CTSchorsch/gesc/pdf/3dview.png

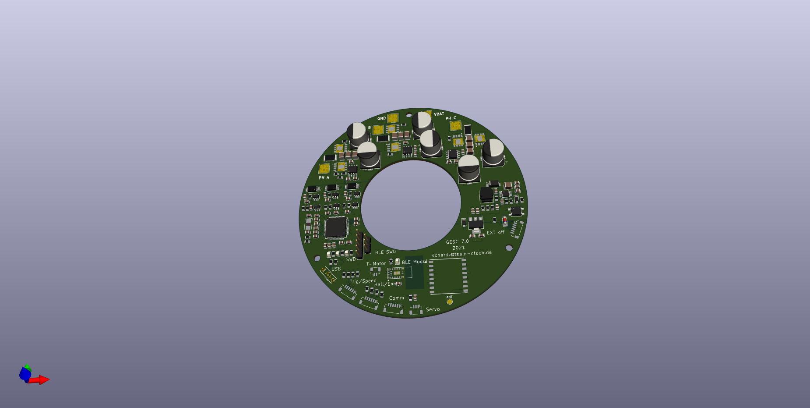
pdf/3dview.png
