CTSchorsch/gesc/README.md

# gesc
DC Motor Controler based on Benjamin Vedders VESC(TM)

Round shape, fits into a DPV tube.
48V (13s), max 60A, needs cooling
