CTSchorsch/gesc/assembly/gesc_lcsc.xlsx

Comment | Designator | Footprint | LCSC
10n0 | C14,C24,C41 | 0805 | C1710 (https://lcsc.com/product-detail/Multilayer-Ceramic-Capacitors-MLCC-SMD-SMT_SAMSUNG_CL21B103KBANNNC_10nF-103-10-50V_C1710.html/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)
10u0/75V | C16,C36,C37,C38,C39,C43,C44,C51,C52,C53
100n | C1,C2,C5,C17,C18,C19,C20,C21,C25,C27,C30,C31,C32,C33,C45,C46,C48 | 0805 | C49678 (https://lcsc.com/product-detail/Multilayer-Ceramic-Capacitors-MLCC-SMD-SMT_100nF-104-10-50V_C49678.html/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)
1n00 | C23,C35,C40,C47 | 0805 | C46653
22u0/25V | C26,C28,C34,C50 | 0805 | C45783 (https://lcsc.com/product-detail/Multilayer-Ceramic-Capacitors-MLCC-SMD-SMT_SAMSUNG_CL21A226MAQNNNE_22uF-226-20-25V_C45783.html/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)
15p0 | C3,C4 | 0805 | C1794
10u0/25V | C6,C7,C8,C9,C10,C11,C12,C13,C15,C22,C29,C42,C49 | 0805 | C15850 (https://lcsc.com/product-detail/Multilayer-Ceramic-Capacitors-MLCC-SMD-SMT_SAMSUNG_CL21A106KAYNNNE_10uF-106-10-25V_C15850.html/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)
330u | C54,C56
BLUE | D1 | LED_0805 | C2293 (https://lcsc.com/product-detail/Light-Emitting-Diodes-LED_Hubei-KENTO-Elec-Blue-light_C2293.html/?href=jlc-SMT)
RED | D2,D11 | LED_0805 | C2296 (https://lcsc.com/product-detail/Light-Emitting-Diodes-LED_Yellow-light-0805-Highlighted_C2296.html/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)
GREEN | D3 | LED_0805 | C2297 (https://lcsc.com/product-detail/Light-Emitting-Diodes-LED_Green-0805-Iv-207-249-mcd-atIF-20mA_C2297.html/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)
SS210 | D4,D8 | SMA,DO-214AC | C14996
B5819W | D5,D6,D7 | SOD-123 | C8598 (https://lcsc.com/product-detail/Schottky-Barrier-Diodes-SBD_Changjiang-Electronics-Tech-CJ-B5819W_C8598.html/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)
330u | L1 | SMD-12.5x12.5x8 | C169381 (https://lcsc.com/product-detail/Power-Inductors_Sunlord-SWRB1207S-331MT_C169381.html/?href=jlc-SMT)
4u70 | L2 | SMD-5.2x5.4x2.8 | C408410 (https://lcsc.com/product-detail/Power-Inductors_Sunlord-MWSA0503S-4R7MT_C408410.html/?href=jlc-SMT)
BSC070N10NS5 | Q1,Q2,Q3,Q4,Q5,Q6 | PG-TDSON-8_EP_5.2x6.2x1.27P | C151549 (https://lcsc.com/product-detail/MOSFET_Infineon-Technologies_BSC070N10NS5ATMA1_Infineon-Technologies-BSC070N10NS5ATMA1_C151549.html/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)
221r | R10,R11 | 0805 | C17557 (https://lcsc.com/product-detail/Chip-Resistor-Surface-Mount_Uniroyal-Elec-0805W8F2200T5E_C17557.html/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)
220k | R12 | 0805 | C17556 (https://lcsc.com/product-detail/Chip-Resistor-Surface-Mount_Uniroyal-Elec-0805W8F2203T5E_C17556.html/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)
100k | R15 | 0805 | C17407 (https://lcsc.com/product-detail/Chip-Resistor-Surface-Mount_Uniroyal-Elec-0805W8F1003T5E_C17407.html/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)
10r0 | R2,R3,R5,R25,R26,R28,R32,R42,R43 | 0805 | C17415 (https://lcsc.com/product-detail/Chip-Resistor-Surface-Mount_Uniroyal-Elec-0805W8F100JT5E_C17415.html/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)
56k0 | R13,R17,R19,R21 | 0805 | C17756 (https://lcsc.com/product-detail/Chip-Resistor-Surface-Mount_Uniroyal-Elec-0805W8F5602T5E_C17756.html/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)
0r001 | R31,R45,R46
7k50 | R35 | 0805 | C17807 (https://lcsc.com/product-detail/Chip-Resistor-Surface-Mount_Uniroyal-Elec-0805W8F7501T5E_C17807.html/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)
0r00 | R1,R37 | 0805 | C17477 (https://lcsc.com/product-detail/Chip-Resistor-Surface-Mount_Uniroyal-Elec-0805W8F0000T5E_C17477.html/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)
4r75 | R24,R38,R39 | 0805 | C17675 (https://lcsc.com/product-detail/Chip-Resistor-Surface-Mount_Uniroyal-Elec-0805W8F470KT5E_C17675.html/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)
33k0 | R44 | 0805 | C17633 (https://lcsc.com/product-detail/Chip-Resistor-Surface-Mount_Uniroyal-Elec-0805W8F3302T5E_C17633.html/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)
2k70 | R4,R6,R7,R14,R18,R20,R22,R23 | 0805 | C17530 (https://lcsc.com/product-detail/Chip-Resistor-Surface-Mount_Uniroyal-Elec-0805W8F2701T5E_C17530.html/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)
11k0 | R8,R16,R27,R34,R36,R40,R41 | 0805 | C17429 (https://lcsc.com/product-detail/Chip-Resistor-Surface-Mount_Uniroyal-Elec-0805W8F1102T5E_C17429.html/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)
1k00 | R9,R29,R30,R33 | 0805 | C17513 (https://lcsc.com/product-detail/Chip-Resistor-Surface-Mount_Uniroyal-Elec-0805W8F1001T5E_C17513.html/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)
STM32F405RGTx | U1 | LQFP-64_10.0x10.0x0.5P | C15742
LM5008MM | U10 | VSSOP-8_3.0x3.0x0.65P | C9424
SN74LVC1G66DBVR | U2,U7,U8,U9,U11,U13 | SOT-23-5 | C133643
AQY282S | U14 | SOP-4_4.3X4.4X2.54P | C250827
EYSGJNZWY | U16
LMR12010YMKE_NOPB | U17 | SOT-23-6L | C57930
LM5107 | U3,U12,U15 | SOIC-8_3.9x4.9x1.27P | C132096
INA240A1 | U4,U5,U6 | TSSOP-8_3.0x4.4x0.65P | C93965
X50328MSB2GI | Y1 | SMD-5032_2P | C115962
