CTSchorsch/gesc/pdf/gesc.pdf

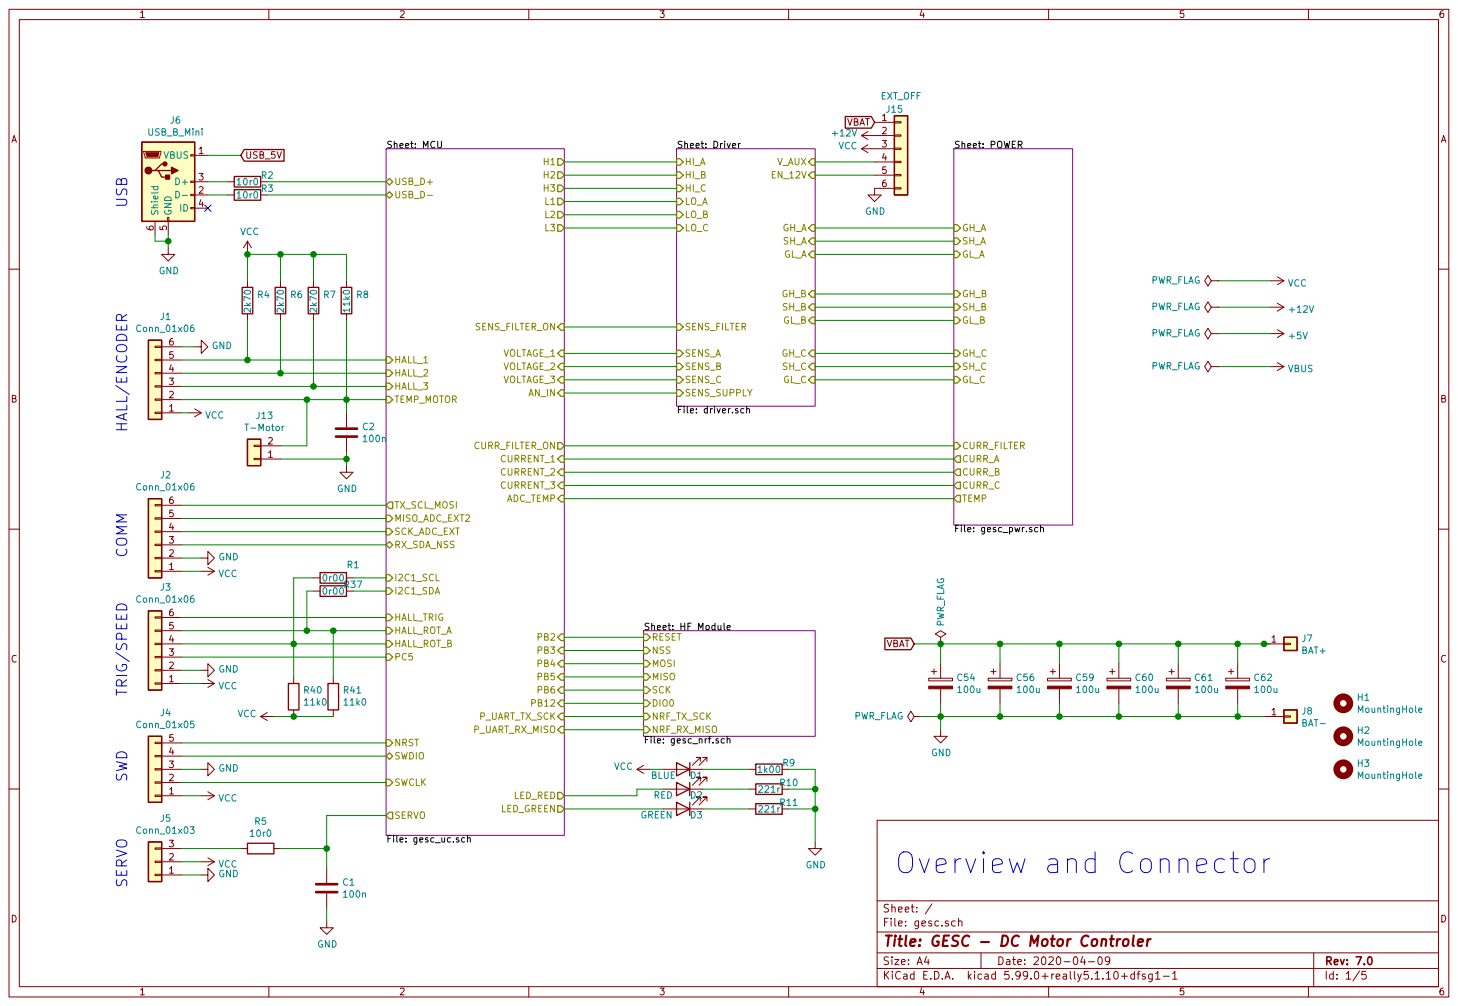
[picture p2: page 1]

File: gesc.sch Sheet: / Sheet: HF Module File: gesc_nrf.sch NRF_TX_SCK NRF_RX_MISO MOSI NSS RESET SCK MISO

Id: 1/5 Title: GESC - DC Motor Controler

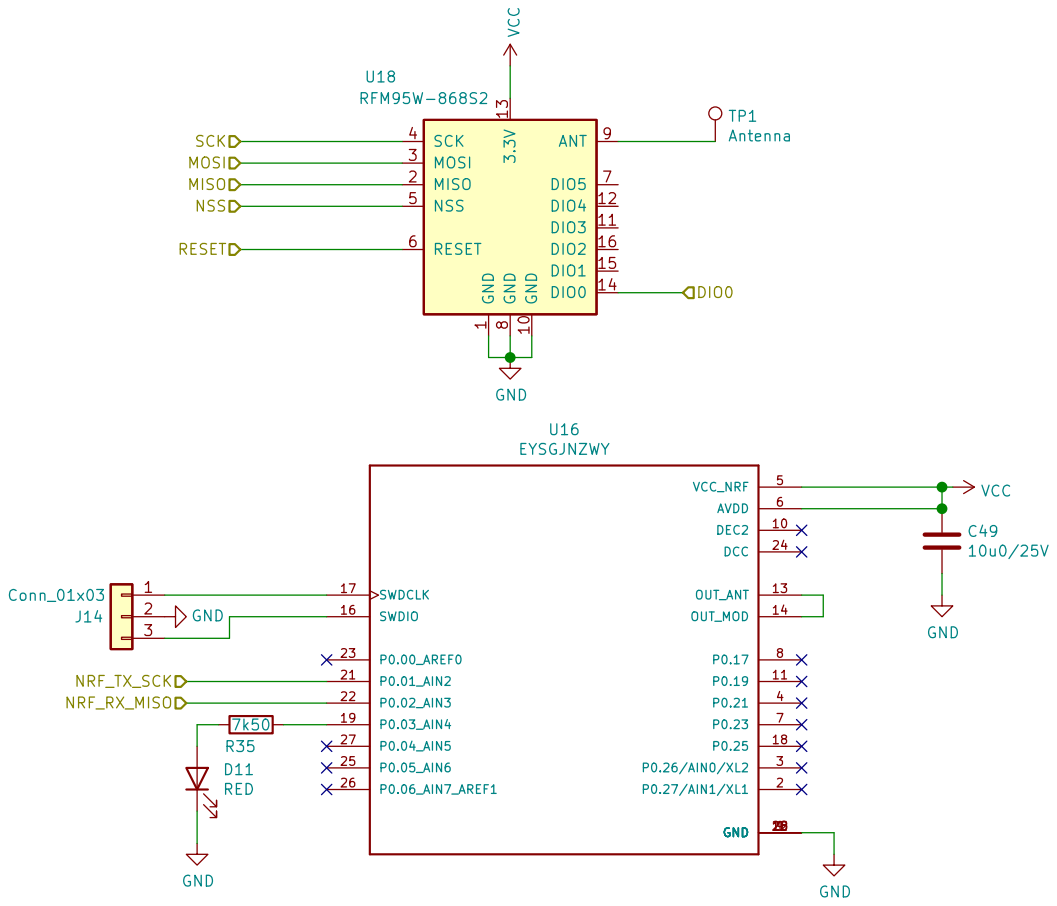
[picture p3: page 2]

8 ANT 9 U18 RFM95W-868S2 C49
File: gesc_nrf.sch Sheet: /HF Module/ GND GND

1 GND 10 DIO3 11 DIO4 12 3.3V 13 DIO0 14 DIO1 15 DIO2 16 MISO 2 MOSI 3 SCK 4 NSS 5 RESET 6 DIO5 7 GND

Id: 2/5 Title: GESC - DC Motor Controler

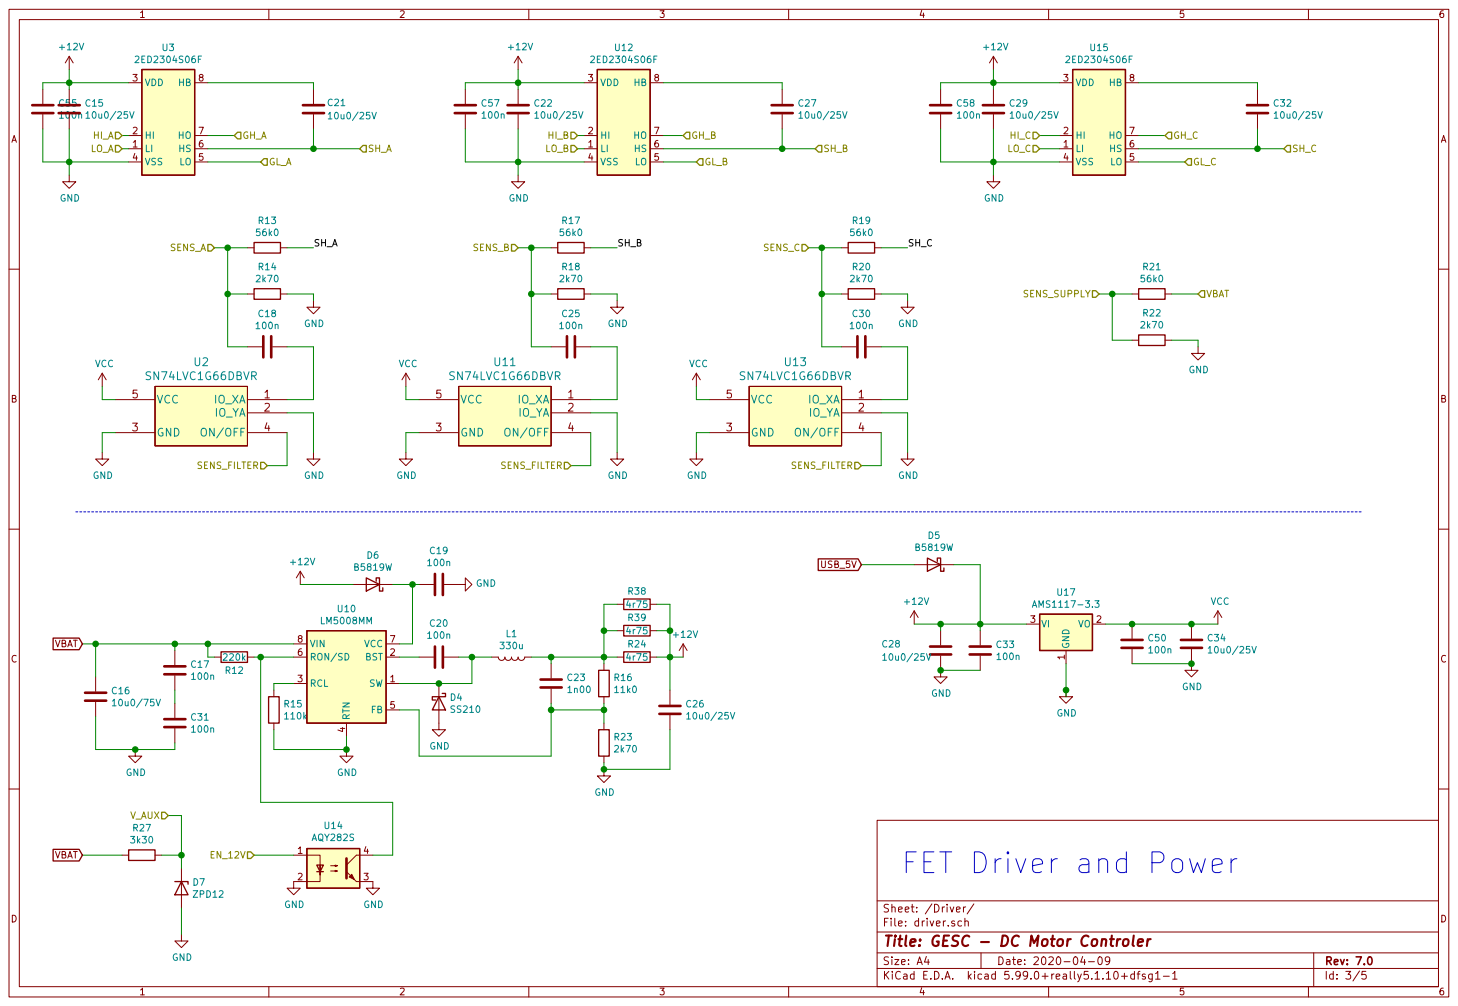
[picture p4: page 3]

4 FB 5 RON/SD 6 VCC 7 VIN 8 U10

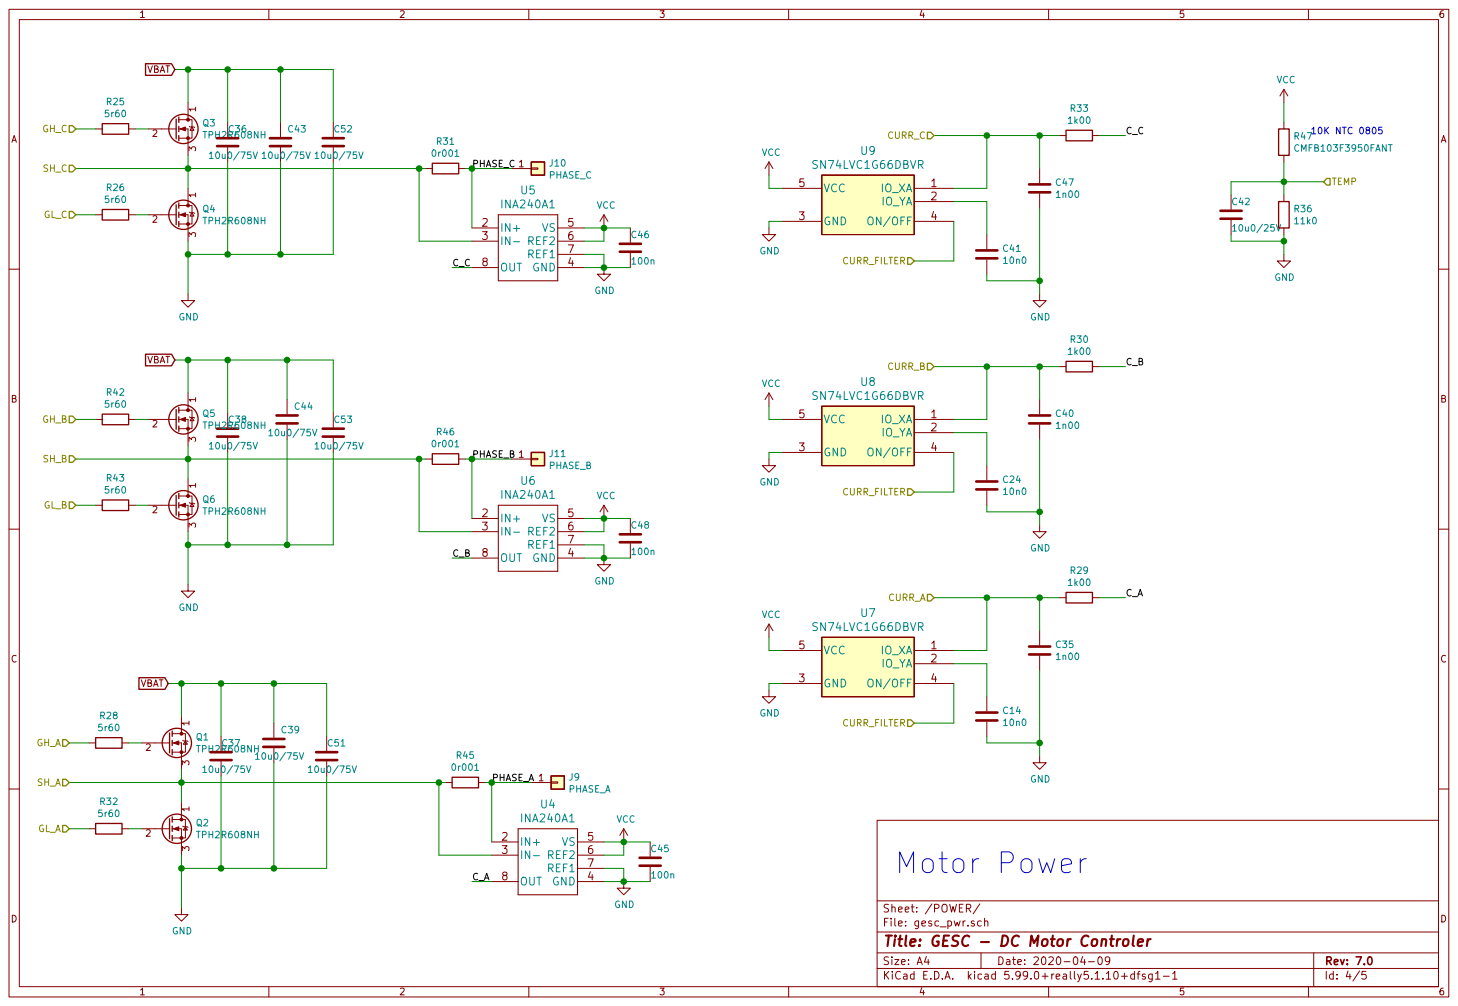
[picture p5: page 4]

File: gesc_pwr.sch Sheet: /POWER/
Id: 4/5 Title: GESC - DC Motor Controler

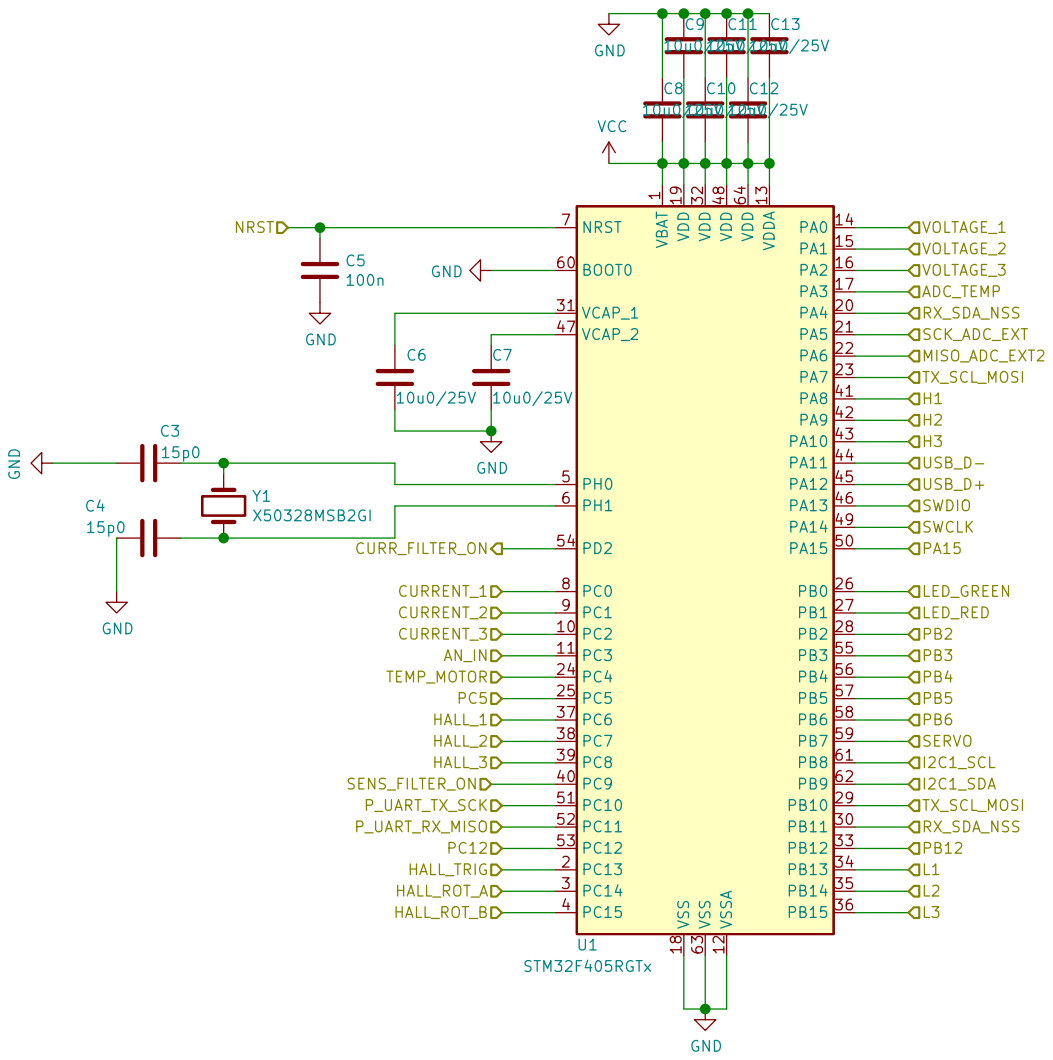
[picture p6: page 5]

File: gesc_uc.sch Sheet: /MCU/ GND

Id: 5/5 Title: GESC - DC Motor Controler
