CTSchorsch/gesc/gerber/gesc-F_CrtYd.pdf

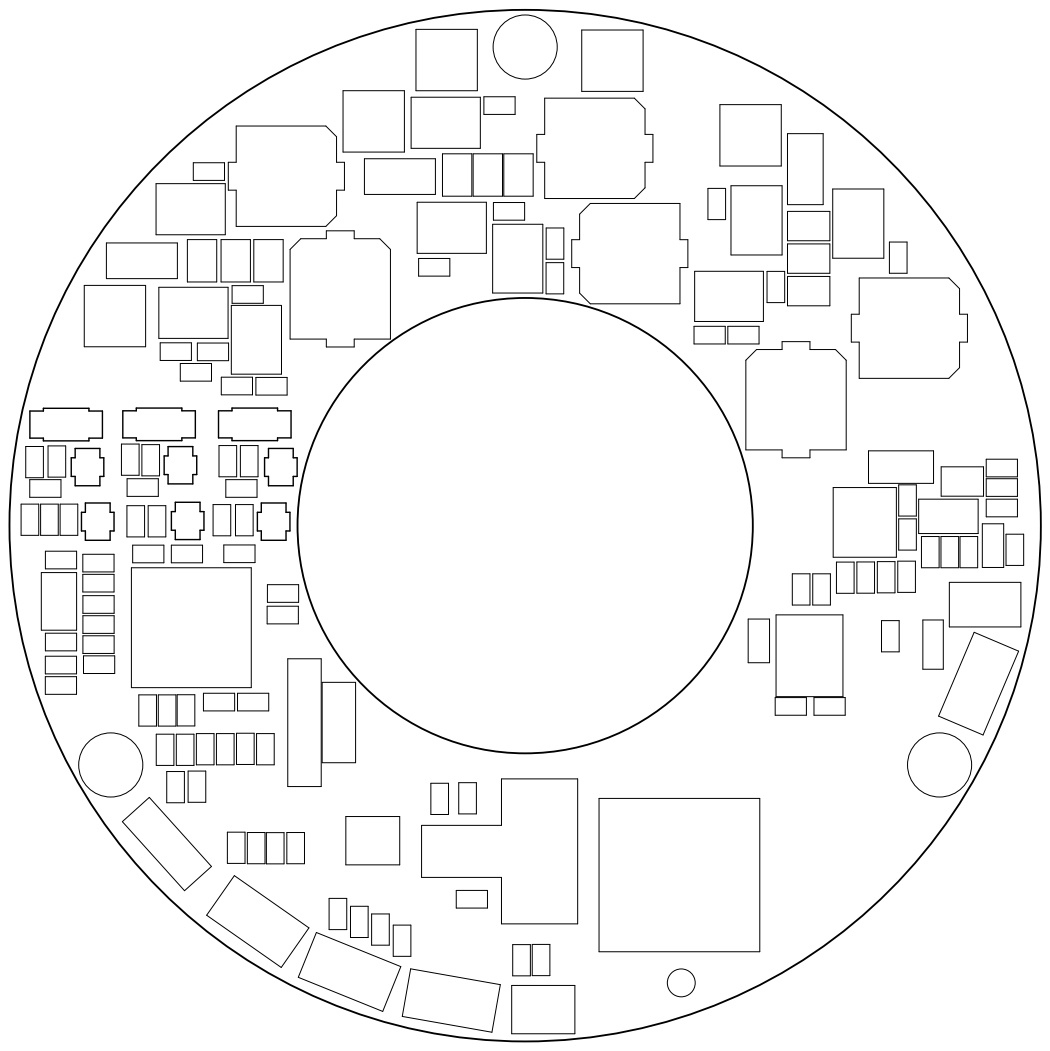
[picture p7: page 1]
