CTSchorsch/gesc/gerber/gesc-F_Fab.pdf

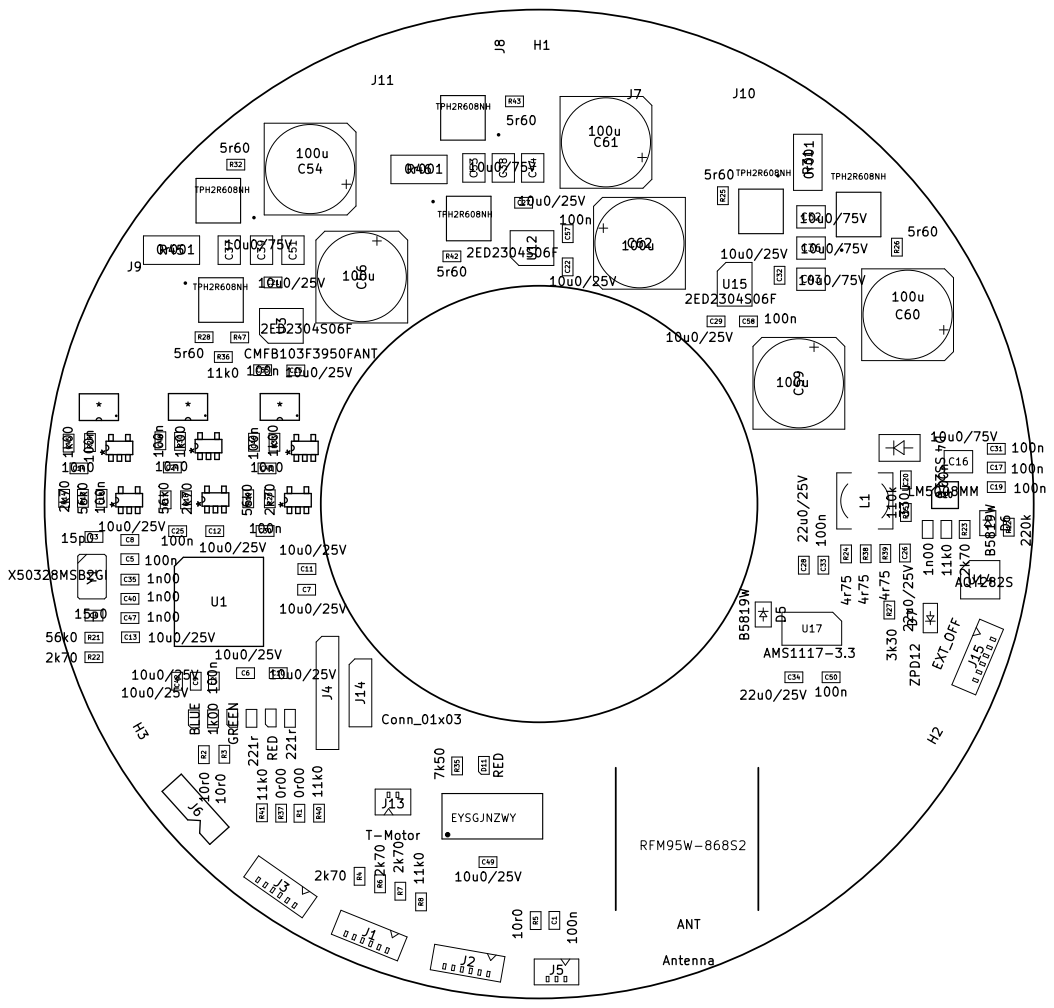
[picture p8: page 1]
