CTSchorsch/gesc/gesc.kicad_pcb

## KiCad design gesc.kicad_pcb (2021-12-03)

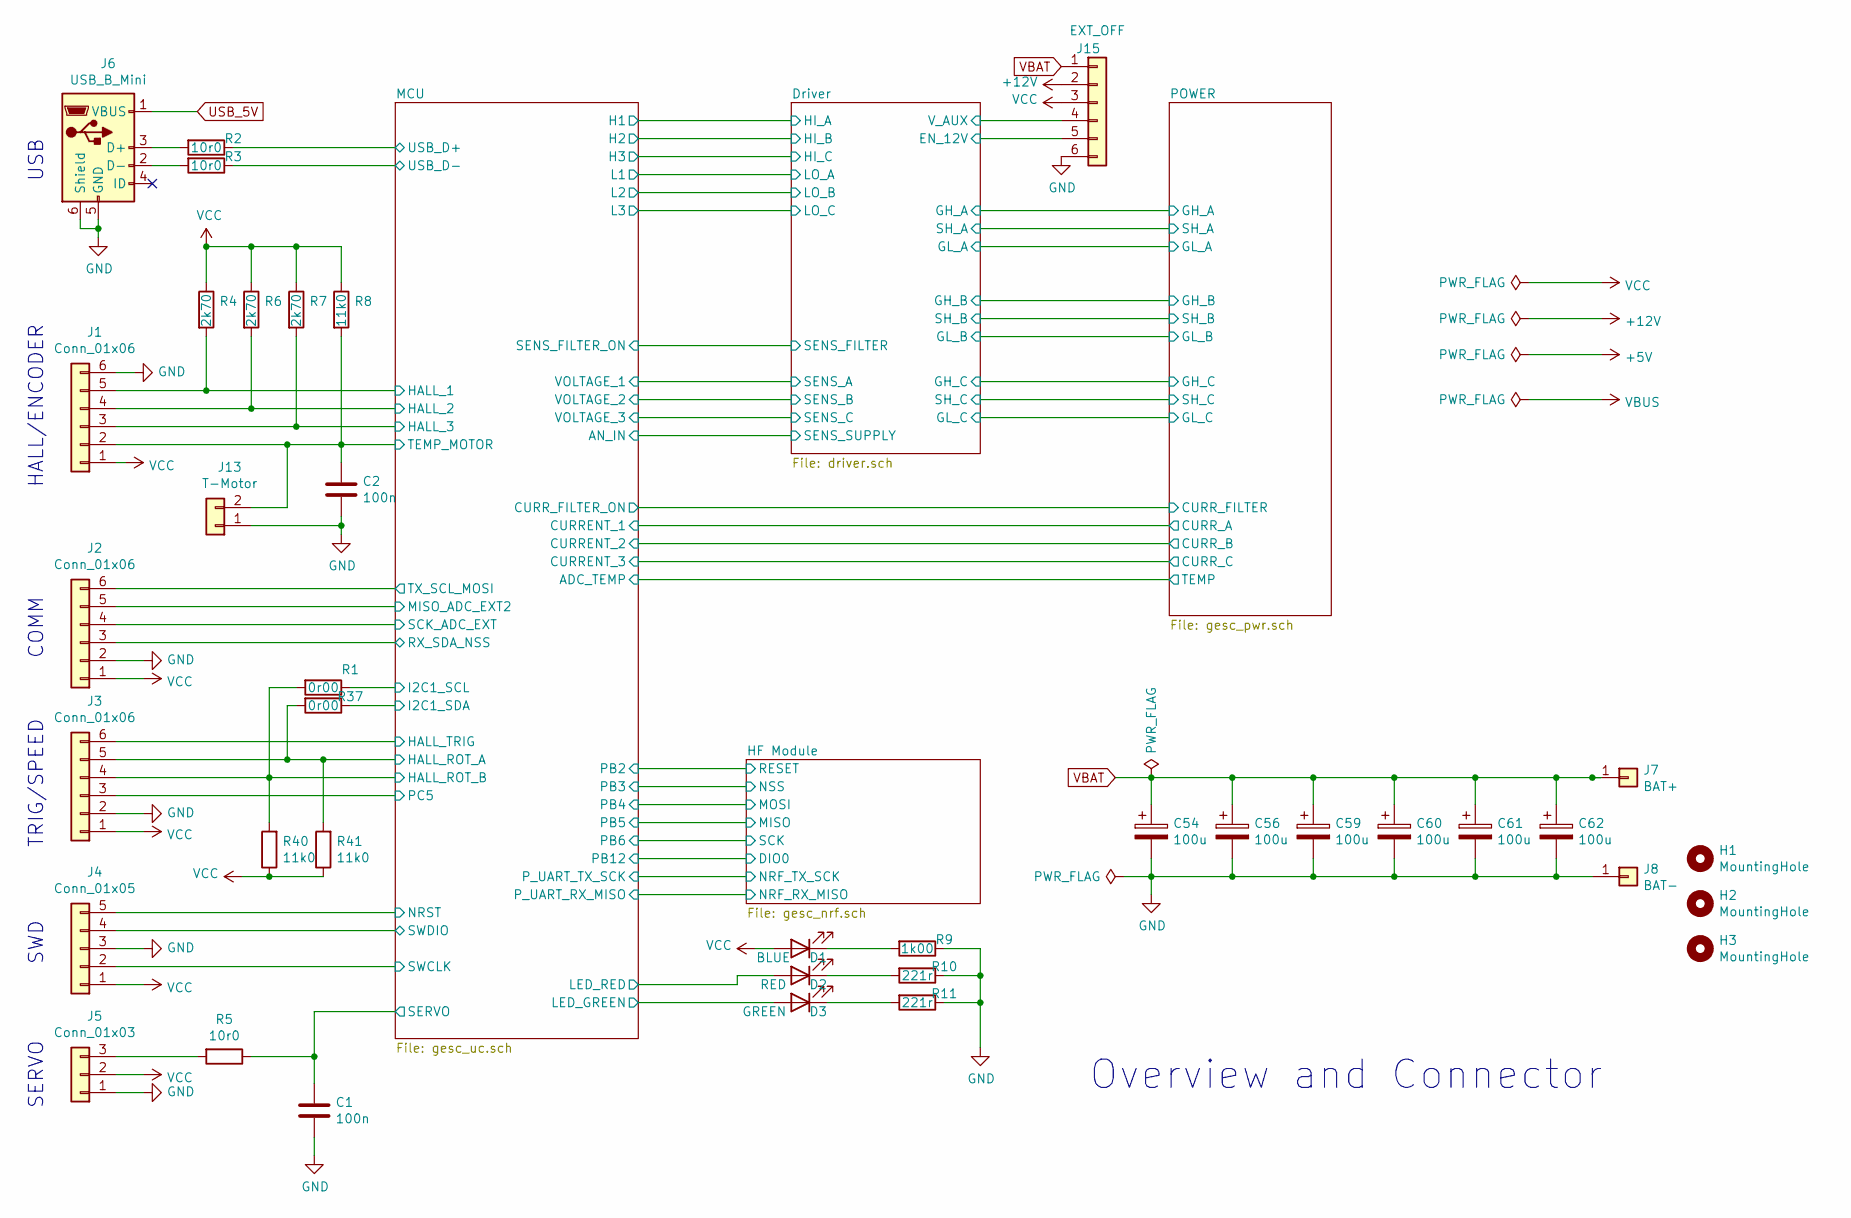
[picture p9: schematic gesc.sch, GESC - DC Motor Controler]

Parts:
C1, C2: 100n; C_0805_2012Metric
C54, C56, C59, C60, C61, C62: 100u; CP_Elec_10x10
D1: BLUE; LED_0805_2012Metric
D2: RED; LED_0805_2012Metric
D3: GREEN; LED_0805_2012Metric
H1, H2, H3: MountingHole; MountingHole_3.2mm_M3
J1, J2, J3: Conn_01x06; JST_SH_BM06B-SRSS-TB_1x06-1MP_P1.00mm_Vertical
J4: Conn_01x05; PinHeader_1x05_P2.54mm_Vertical
J5: Conn_01x03; JST_SH_BM03B-SRSS-TB_1x03-1MP_P1.00mm_Vertical
J6: USB_B_Mini; USB_Micro-B_Wuerth_614105150721_Vertical_CircularHoles
J7: BAT+; TestPoint_Pad_5.0x5.0mm
J8: BAT-; TestPoint_Pad_5.0x5.0mm
J13: T-Motor; JST_SH_BM02B-SRSS-TB_1x02-1MP_P1.00mm_Vertical
J15: EXT_OFF; JST_SH_BM06B-SRSS-TB_1x06-1MP_P1.00mm_Vertical
R1, R37: 0r00; R_0805_2012Metric
R2, R3, R5: 10r0; R_0805_2012Metric
R4: 2k70; R_0805_2012Metric; LCSC 1
R6, R7: 2k70; R_0805_2012Metric
R8, R40, R41: 11k0; R_0805_2012Metric
R9: 1k00; R_0805_2012Metric
R10, R11: 221r; R_0805_2012Metric

Connections:
+12V: J15.2; also elsewhere on the board
/Driver/EN_12V: J15.5; also elsewhere on the board
/Driver/V_AUX: J15.4; also elsewhere on the board
/MCU/HALL_1: J1.5, R4.2; also elsewhere on the board
/MCU/HALL_2: J1.4, R6.2; also elsewhere on the board
/MCU/HALL_3: J1.3, R7.2; also elsewhere on the board
/MCU/HALL_ROT_A: J3.5, R37.2, R41.2; also elsewhere on the board
/MCU/HALL_ROT_B: J3.4, R1.2, R40.2; also elsewhere on the board
/MCU/HALL_TRIG: J3.6; also elsewhere on the board
/MCU/I2C1_SCL: R1.1; also elsewhere on the board
/MCU/I2C1_SDA: R37.1; also elsewhere on the board
/MCU/LED_GREEN: D3.2 (A); also elsewhere on the board
/MCU/LED_RED: D2.2 (A); also elsewhere on the board
/MCU/MISO_ADC_EXT2: J2.5; also elsewhere on the board
/MCU/NRST: J4.5; also elsewhere on the board
/MCU/PC5: J3.3; also elsewhere on the board
/MCU/RX_SDA_NSS: J2.3; also elsewhere on the board
/MCU/SCK_ADC_EXT: J2.4; also elsewhere on the board
/MCU/SERVO: C1.1, R5.1; also elsewhere on the board
/MCU/SWCLK: J4.2; also elsewhere on the board
/MCU/SWDIO: J4.4; also elsewhere on the board
/MCU/TEMP_MOTOR: C2.1, J1.2, J13.2, R8.2; also elsewhere on the board
/MCU/TX_SCL_MOSI: J2.6; also elsewhere on the board
/MCU/USB_D+: R2.1; also elsewhere on the board
/MCU/USB_D-: R3.1; also elsewhere on the board
GND: C1.2, C2.2, C54.2, C56.2, C59.2, C60.2, C61.2, C62.2, J1.6, J2.2, J3.2, J4.3, J5.1, J6.5 (GND), J6.6 (Shield), J8.1, J13.1, J15.6, R9.1, R10.1, R11.1; also elsewhere on the board
unnamed: D1.1 (K), R9.2
unnamed: D2.1 (K), R10.2
unnamed: D3.1 (K), R11.2
unnamed: J5.3, R5.2
unnamed: J6.2 (D-), R3.2
unnamed: J6.3 (D+), R2.2
USB_5V: J6.1 (VBUS); also elsewhere on the board
VBAT: C54.1, C56.1, C59.1, C60.1, C61.1, C62.1, J7.1, J15.1; also elsewhere on the board
VCC: D1.2 (A), J1.1, J2.1, J3.1, J4.1, J5.2, J15.3, R4.1, R6.1, R7.1, R8.1, R40.1, R41.1; also elsewhere on the board

Notes on the sheet:
Overview and Connector
USB
HALL/ENCODER
COMM
TRIG/SPEED
SWD
SERVO

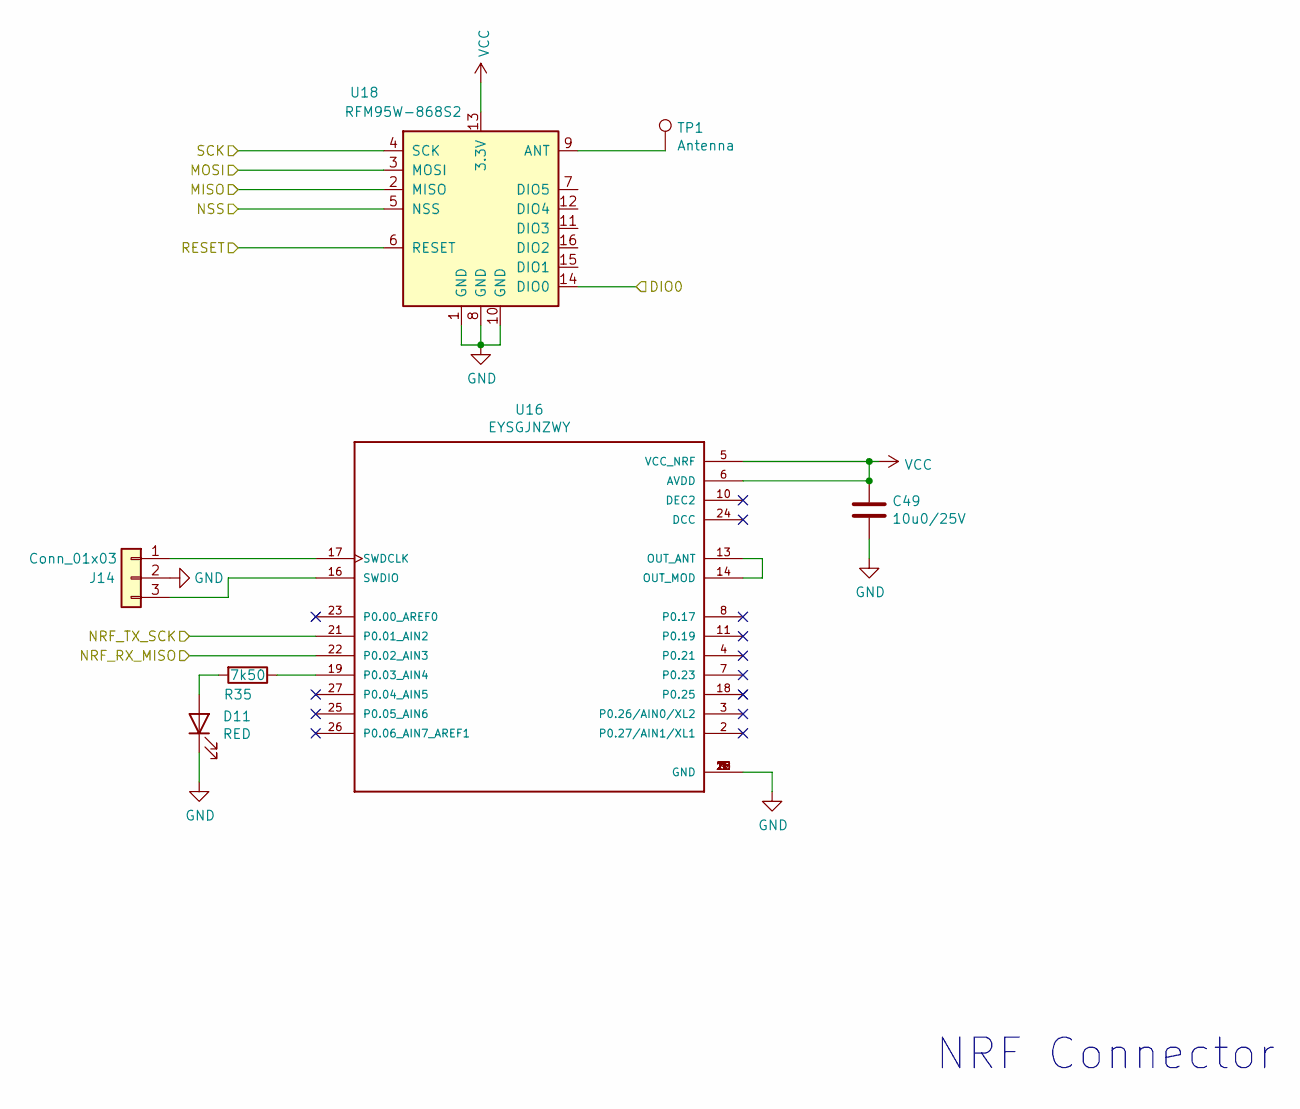
[picture p10: schematic gesc_nrf.sch, GESC - DC Motor Controler]

Parts:
C49: 10u0/25V; C_0805_2012Metric
D11: RED; LED_0805_2012Metric
J14: Conn_01x03; PinHeader_1x03_P2.54mm_Vertical
R35: 7k50; R_0805_2012Metric
TP1: Antenna; TestPoint_Pad_D2.0mm
U16: EYSGJNZWY; BLE_EYSGJNZWY
U18: RFM95W-868S2; XCVR_RFM95W-868S2

Connections:
/HF Module/DIO0: U18.14 (DIO0); also elsewhere on the board
/HF Module/MISO: U18.2 (MISO); also elsewhere on the board
/HF Module/MOSI: U18.3 (MOSI); also elsewhere on the board
/HF Module/NRF_RX_MISO: U16.22 (P0.02_AIN3); also elsewhere on the board
/HF Module/NRF_TX_SCK: U16.21 (P0.01_AIN2); also elsewhere on the board
/HF Module/NSS: U18.5 (NSS); also elsewhere on the board
/MCU/PB2: U18.6 (RESET); also elsewhere on the board
/MCU/PB6: U18.4 (SCK); also elsewhere on the board
GND: C49.2, D11.1 (K), J14.2, U16.1 (GND), U16.9 (GND), U16.12 (GND), U16.15 (GND), U16.20 (GND), U16.28 (GND), U18.1 (GND), U18.8 (GND), U18.10 (GND); also elsewhere on the board
unnamed: D11.2 (A), R35.2
unnamed: J14.1, U16.17 (SWDCLK)
unnamed: J14.3, U16.16 (SWDIO)
unnamed: R35.1, U16.19 (P0.03_AIN4)
unnamed 102: TP1.1, U18.9 (ANT); also elsewhere on the board
unnamed: U16.13 (OUT_ANT), U16.14 (OUT_MOD)
VCC: C49.1, U16.5 (VCC_NRF), U16.6 (AVDD), U18.13 (3.3V); also elsewhere on the board

Notes on the sheet:
NRF Connector

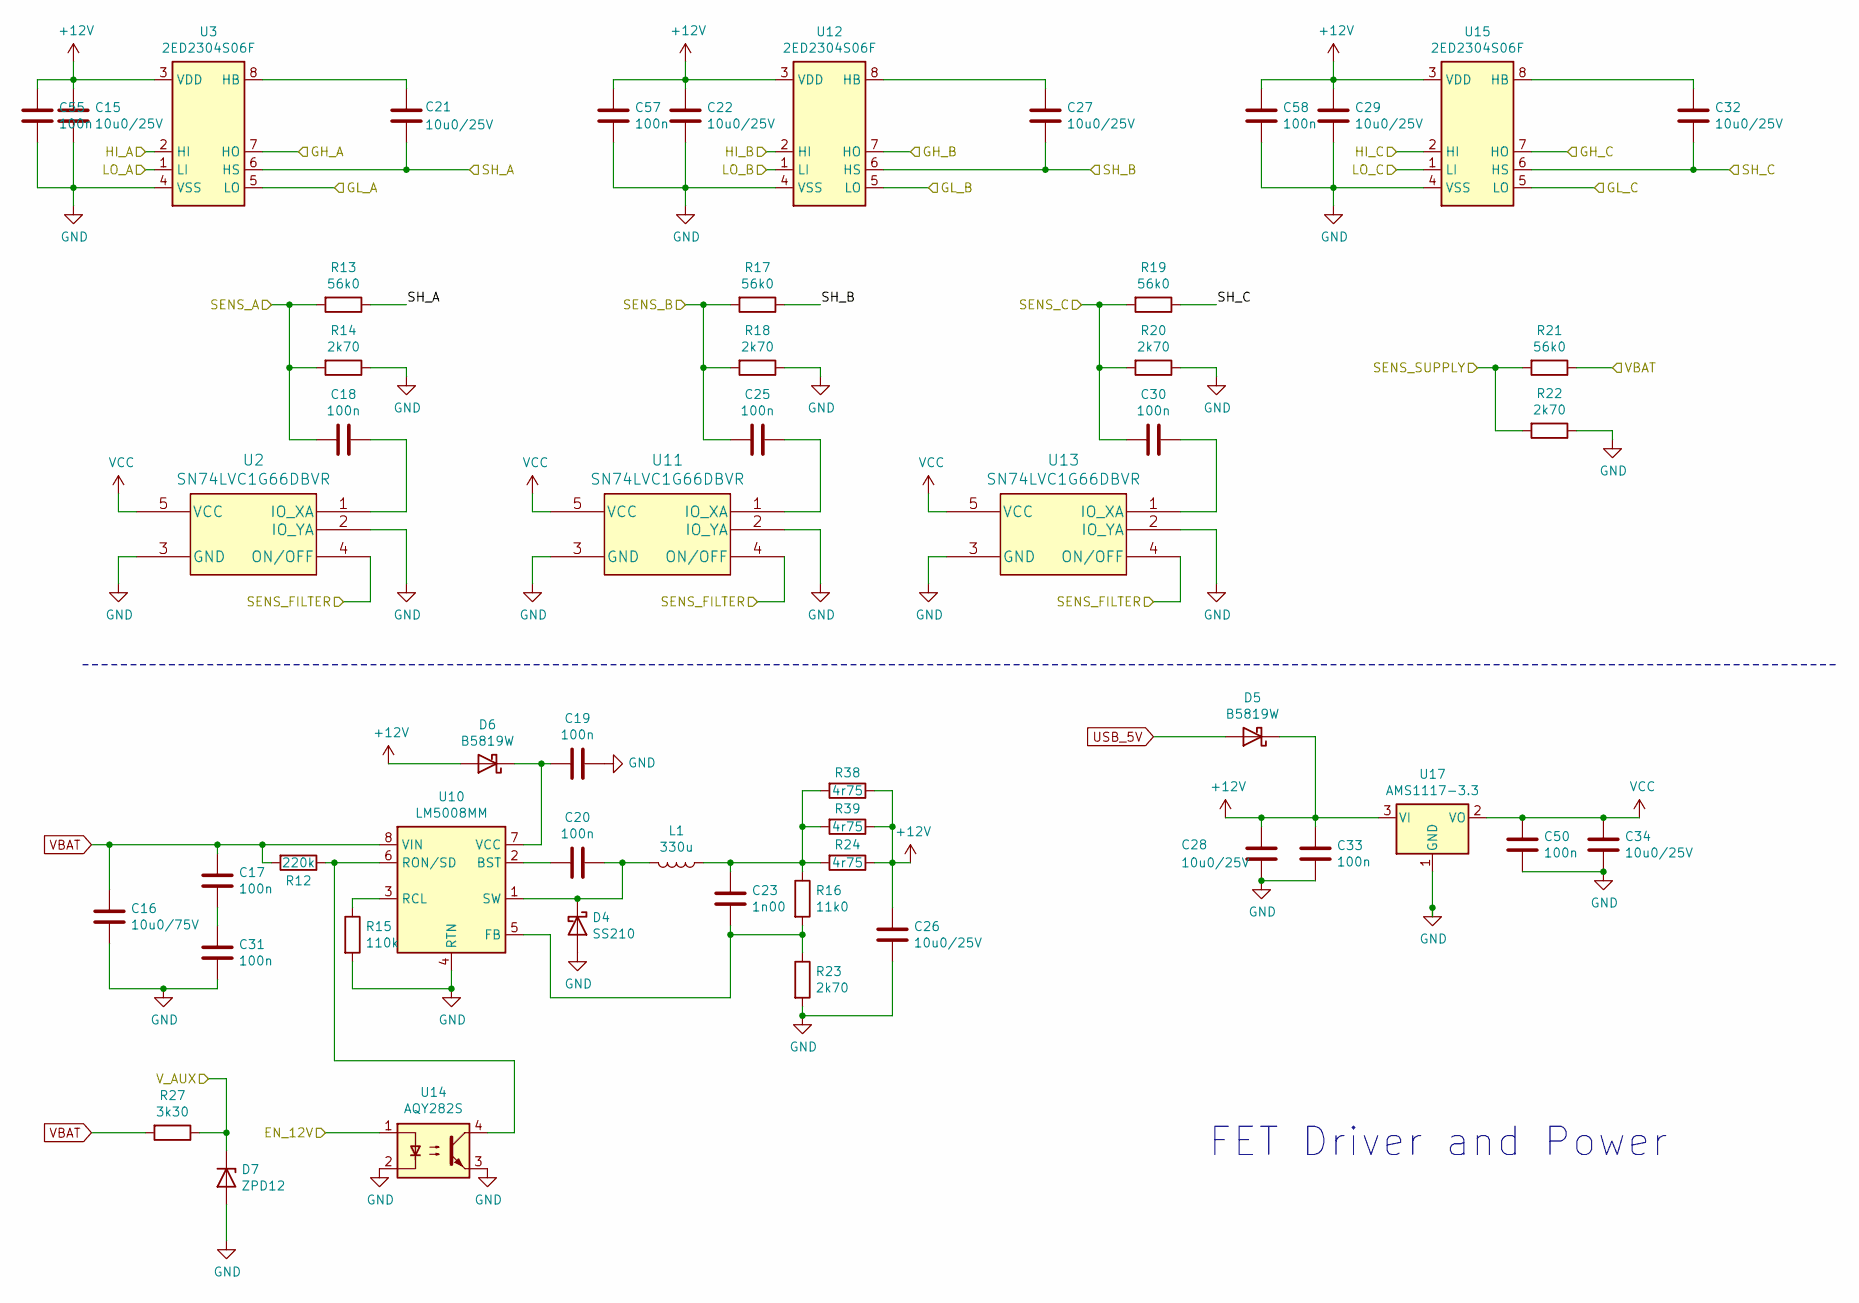
[picture p11: schematic driver.sch, GESC - DC Motor Controler]

Parts:
C15, C21, C22, C26, C27, C28, C29, C32, C34: 10u0/25V; C_0805_2012Metric
C16: 10u0/75V; C_1210_3225Metric
C17, C18, C19, C20, C25, C30, C31, C33, C50, C55, C57, C58: 100n; C_0805_2012Metric
C23: 1n00; C_0805_2012Metric
D4: SS210; D_SMA; LCSC C14996
D5, D6: B5819W; D_SOD-123; LCSC C8598
D7: ZPD12; D_MiniMELF
L1: 330u; L_6.3x6.3_H3; Partnumber SWPA6045S331MT; LCSC C83453
R12: 220k; R_0805_2012Metric
R13, R17, R19, R21: 56k0; R_0805_2012Metric
R14, R18, R20, R22, R23: 2k70; R_0805_2012Metric
R15: 110k; R_0805_2012Metric
R16: 11k0; R_0805_2012Metric
R24, R38, R39: 4r75; R_0805_2012Metric
R27: 3k30; R_0805_2012Metric
U2, U11, U13: SN74LVC1G66DBVR; M74VHC1GT66DTT1G; LCSC C133643
U3, U12, U15: 2ED2304S06F; SOIC-8_3.9x4.9mm_P1.27mm
U10: LM5008MM; MSOP-8_3x3mm_P0.65mm; LCSC C9424
U14: AQY282S; SO-4_4.4x4.3mm_P2.54mm; LCSC C250827
U17: AMS1117-3.3; SOT-223-3_TabPin2

Connections:
+12V: C15.1, C22.1, C26.1, C28.1, C29.1, C33.1, C55.1, C57.1, C58.1, D5.1 (K), D6.2 (A), R24.1, R38.1, R39.1, U3.3 (VDD), U12.3 (VDD), U15.3 (VDD), U17.3 (VI); also elsewhere on the board
/Driver/EN_12V: U14.1; also elsewhere on the board
/Driver/GH_A: U3.7 (HO); also elsewhere on the board
/Driver/GH_B: U12.7 (HO); also elsewhere on the board
/Driver/GH_C: U15.7 (HO); also elsewhere on the board
/Driver/GL_A: U3.5 (LO); also elsewhere on the board
/Driver/GL_B: U12.5 (LO); also elsewhere on the board
/Driver/GL_C: U15.5 (LO); also elsewhere on the board
/Driver/SENS_A: C18.2, R13.2, R14.2; also elsewhere on the board
/Driver/SENS_B: C25.2, R17.2, R18.2; also elsewhere on the board
/Driver/SENS_C: C30.2, R19.2, R20.2; also elsewhere on the board
/Driver/SENS_FILTER: U2.4 (ON/OFF), U11.4 (ON/OFF), U13.4 (ON/OFF); also elsewhere on the board
/Driver/SH_A: C21.2, R13.1, U3.6 (HS); also elsewhere on the board
/Driver/SH_B: C27.2, R17.1, U12.6 (HS); also elsewhere on the board
/Driver/SH_C: C32.2, R19.1, U15.6 (HS); also elsewhere on the board
/Driver/V_AUX: D7.1 (K), R27.1; also elsewhere on the board
/MCU/AN_IN: R21.2, R22.2; also elsewhere on the board
/MCU/H1: U3.2 (HI); also elsewhere on the board
/MCU/H2: U12.2 (HI); also elsewhere on the board
/MCU/H3: U15.2 (HI); also elsewhere on the board
/MCU/L1: U3.1 (LI); also elsewhere on the board
/MCU/L2: U12.1 (LI); also elsewhere on the board
/MCU/L3: U15.1 (LI); also elsewhere on the board
GND: C15.2, C16.2, C19.2, C22.2, C26.2, C28.2, C29.2, C31.2, C33.2, C34.2, C50.2, C55.2, C57.2, C58.2, D4.2 (A), D7.2 (A), R14.1, R15.2, R18.1, R20.1, R22.1, R23.2, U2.2 (IO_YA), U2.3 (GND), U3.4 (VSS), U10.4 (RTN), U11.2 (IO_YA), U11.3 (GND), U12.4 (VSS), U13.2 (IO_YA), U13.3 (GND), U14.2, U14.3, U15.4 (VSS), U17.1 (GND); also elsewhere on the board
unnamed: C17.2, C31.1
unnamed: C18.1, U2.1 (IO_XA)
unnamed: C19.1, D6.1 (K), U10.7 (VCC)
unnamed: C20.1, U10.2 (BST)
unnamed: C20.2, D4.1 (K), L1.2, U10.1 (SW)
unnamed: C21.1, U3.8 (HB)
unnamed: C23.1, L1.1, R16.1, R24.2, R38.2, R39.2
unnamed: C23.2, R16.2, R23.1, U10.5 (FB)
unnamed: C25.1, U11.1 (IO_XA)
unnamed: C27.1, U12.8 (HB)
unnamed: C30.1, U13.1 (IO_XA)
unnamed: C32.1, U15.8 (HB)
unnamed: R12.1, U10.6 (RON/SD), U14.4
unnamed: R15.1, U10.3 (RCL)
USB_5V: D5.2 (A); also elsewhere on the board
VBAT: C16.1, C17.1, R12.2, R21.1, R27.2, U10.8 (VIN); also elsewhere on the board
VCC: C34.1, C50.1, U2.5 (VCC), U11.5 (VCC), U13.5 (VCC), U17.2 (VO); also elsewhere on the board

Notes on the sheet:
FET Driver and Power

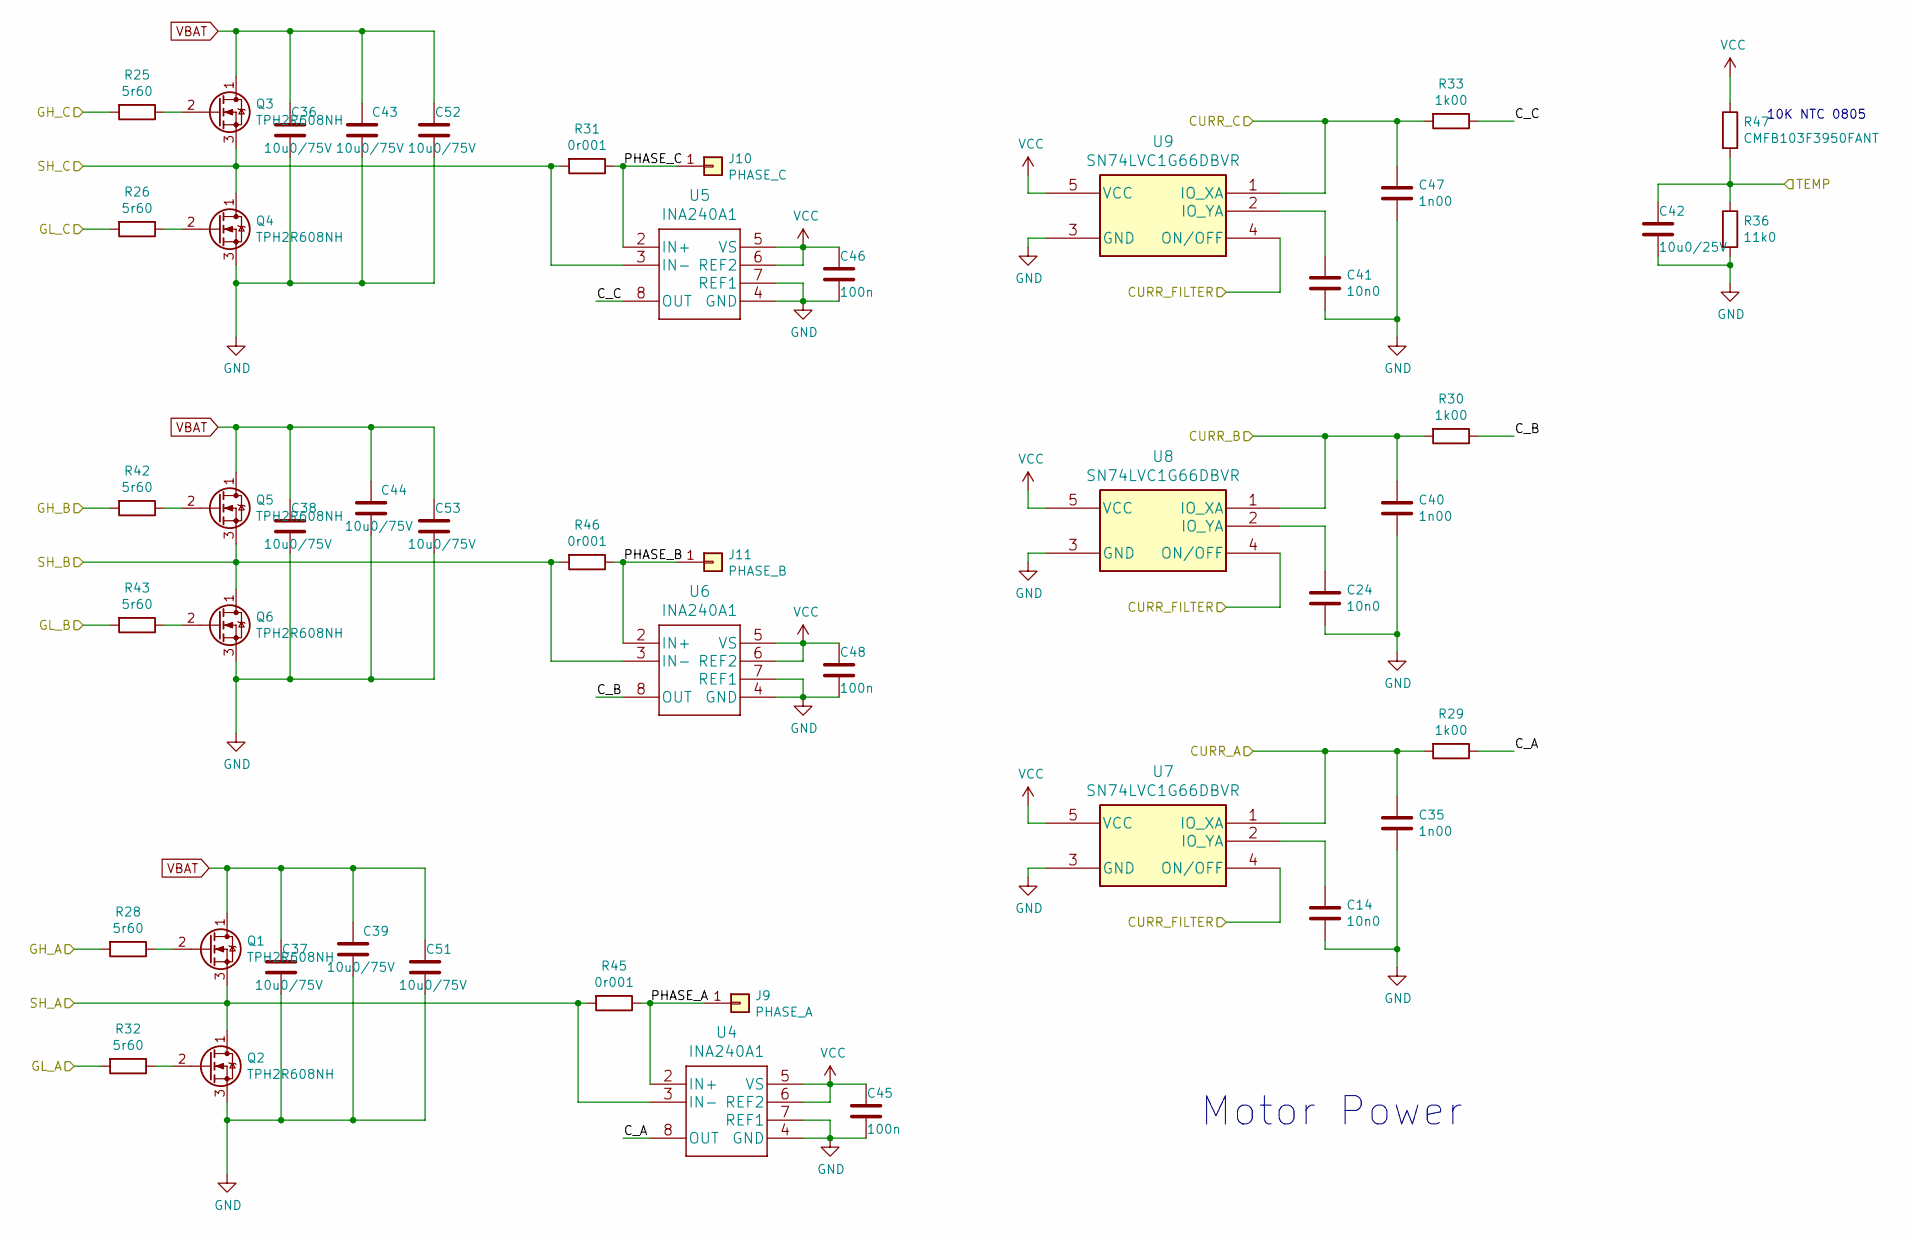
[picture p12: schematic gesc_pwr.sch, GESC - DC Motor Controler]

Parts:
C14, C24, C41: 10n0; C_0805_2012Metric
C35, C40, C47: 1n00; C_0805_2012Metric
C36: 10u0/75V; C_1210_3225Metric; LCSC C15850
C37, C38, C39, C43, C44, C51, C52, C53: 10u0/75V; C_1210_3225Metric
C42: 10u0/25V; C_0805_2012Metric
C45, C46, C48: 100n; C_0805_2012Metric
J9: PHASE_A; TestPoint_Pad_5.0x5.0mm
J10: PHASE_C; TestPoint_Pad_5.0x5.0mm
J11: PHASE_B; TestPoint_Pad_5.0x5.0mm
Q1, Q2, Q3, Q4, Q5, Q6: TPH2R608NH; TRANS_TPHR8504PL-3PIN; Partnumber TPH2R608NH; LCSC C146377
R25, R26, R28, R32, R42, R43: 5r60; R_0805_2012Metric
R29, R30, R33: 1k00; R_0805_2012Metric
R31, R45, R46: 0r001; R_2512_6332Metric
R36: 11k0; R_0805_2012Metric
R47: CMFB103F3950FANT; R_0805_2012Metric
U4, U5, U6: INA240A1; INA240A1QPWRQ1; LCSC C93965
U7, U8, U9: SN74LVC1G66DBVR; M74VHC1GT66DTT1G; LCSC C133643

Connections:
/Driver/GH_A: R28.2; also elsewhere on the board
/Driver/GH_B: R42.2; also elsewhere on the board
/Driver/GH_C: R25.2; also elsewhere on the board
/Driver/GL_A: R32.2; also elsewhere on the board
/Driver/GL_B: R43.2; also elsewhere on the board
/Driver/GL_C: R26.2; also elsewhere on the board
/Driver/SH_A: Q1.3 (S), Q2.1 (D), R45.2, U4.3 (IN-); also elsewhere on the board
/Driver/SH_B: Q5.3 (S), Q6.1 (D), R46.2, U6.3 (IN-); also elsewhere on the board
/Driver/SH_C: Q3.3 (S), Q4.1 (D), R31.2, U5.3 (IN-); also elsewhere on the board
/MCU/ADC_TEMP: C42.1, R36.1, R47.2; also elsewhere on the board
/MCU/CURRENT_1: C35.1, R29.2, U7.1 (IO_XA); also elsewhere on the board
/MCU/CURRENT_2: C40.1, R30.2, U8.1 (IO_XA); also elsewhere on the board
/MCU/CURRENT_3: C47.1, R33.2, U9.1 (IO_XA); also elsewhere on the board
/POWER/CURR_FILTER: U7.4 (ON/OFF), U8.4 (ON/OFF), U9.4 (ON/OFF); also elsewhere on the board
/POWER/C_A: R29.1, U4.8 (OUT)
/POWER/C_B: R30.1, U6.8 (OUT)
/POWER/C_C: R33.1, U5.8 (OUT)
/POWER/PHASE_A: J9.1, R45.1, U4.2 (IN+)
/POWER/PHASE_B: J11.1, R46.1, U6.2 (IN+)
/POWER/PHASE_C: J10.1, R31.1, U5.2 (IN+)
GND: C14.2, C24.2, C35.2, C36.2, C37.2, C38.2, C39.2, C40.2, C41.2, C42.2, C43.2, C44.2, C45.2, C46.2, C47.2, C48.2, C51.2, C52.2, C53.2, Q2.3 (S), Q4.3 (S), Q6.3 (S), R36.2, U4.4 (GND), U4.7 (REF1), U5.4 (GND), U5.7 (REF1), U6.4 (GND), U6.7 (REF1), U7.3 (GND), U8.3 (GND), U9.3 (GND); also elsewhere on the board
unnamed: C14.1, U7.2 (IO_YA)
unnamed: C24.1, U8.2 (IO_YA)
unnamed: C41.1, U9.2 (IO_YA)
unnamed: Q1.2 (G), R28.1
unnamed: Q2.2 (G), R32.1
unnamed: Q3.2 (G), R25.1
unnamed: Q4.2 (G), R26.1
unnamed: Q5.2 (G), R42.1
unnamed: Q6.2 (G), R43.1
VBAT: C36.1, C37.1, C38.1, C39.1, C43.1, C44.1, C51.1, C52.1, C53.1, Q1.1 (D), Q3.1 (D), Q5.1 (D); also elsewhere on the board
VCC: C45.1, C46.1, C48.1, R47.1, U4.5 (VS), U4.6 (REF2), U5.5 (VS), U5.6 (REF2), U6.5 (VS), U6.6 (REF2), U7.5 (VCC), U8.5 (VCC), U9.5 (VCC); also elsewhere on the board

Notes on the sheet:
Motor Power
10K NTC 0805

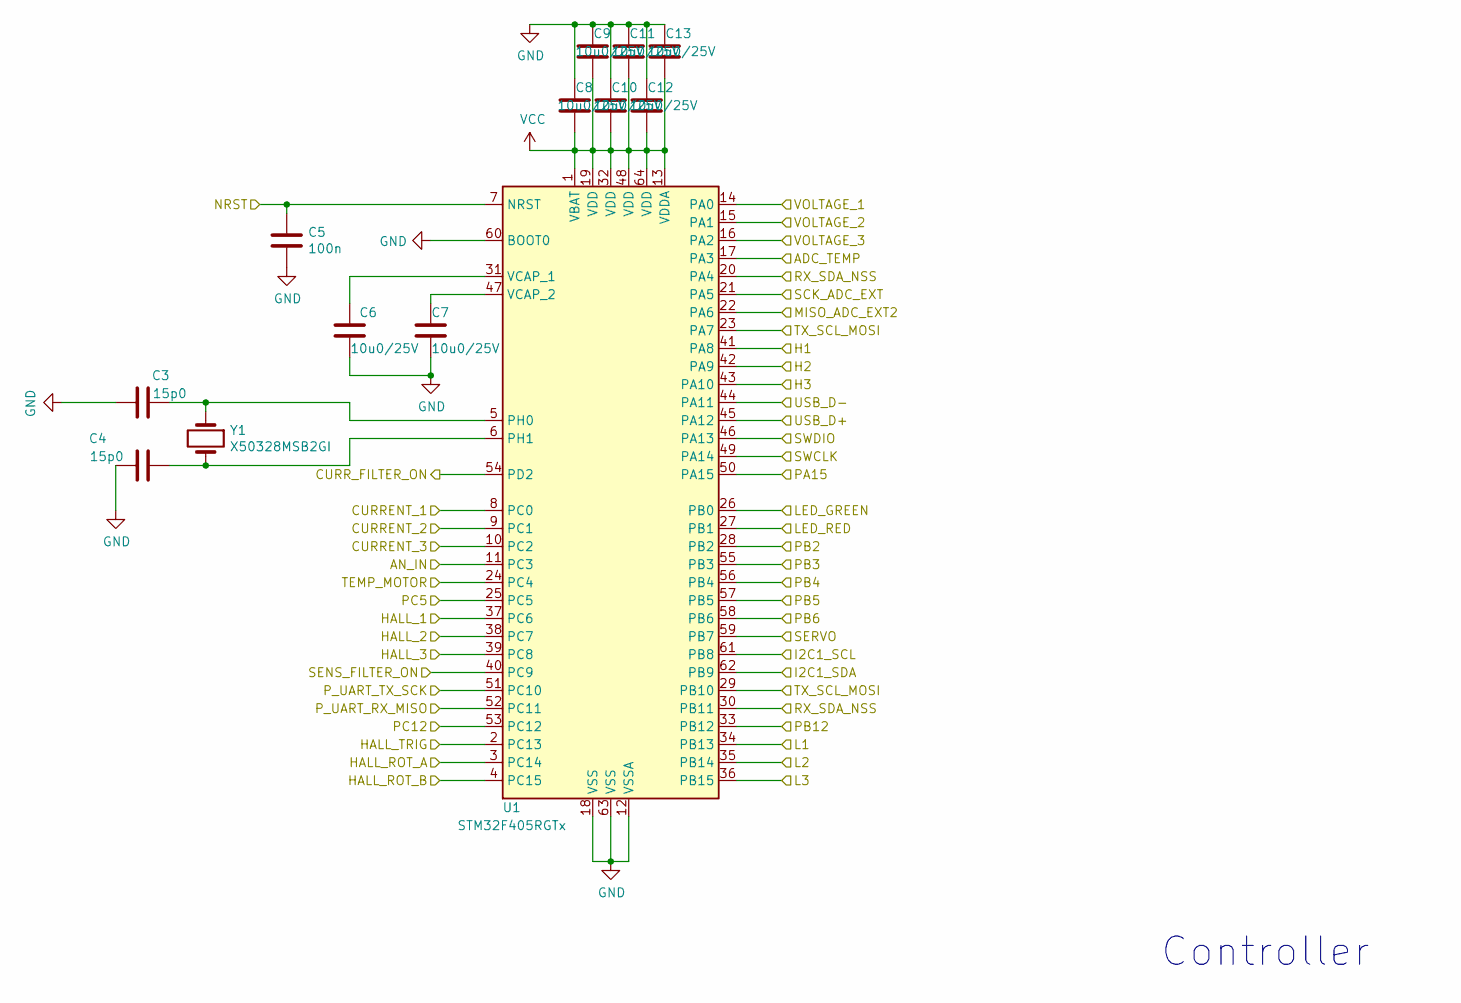
[picture p13: schematic gesc_uc.sch, GESC - DC Motor Controler]

Parts:
C3, C4: 15p0; C_0805_2012Metric
C5: 100n; C_0805_2012Metric
C6, C7, C8, C9, C10, C11, C12, C13: 10u0/25V; C_0805_2012Metric
U1: STM32F405RGTx; LQFP-64_10x10mm_P0.5mm; LCSC C15742
Y1: X50328MSB2GI; Crystal_SMD_5032-2Pin_5.0x3.2mm; LCSC C115962

Connections:
/Driver/SENS_A: U1.14 (PA0); also elsewhere on the board
/Driver/SENS_B: U1.15 (PA1); also elsewhere on the board
/Driver/SENS_C: U1.16 (PA2); also elsewhere on the board
/Driver/SENS_FILTER: U1.40 (PC9); also elsewhere on the board
/HF Module/DIO0: U1.33 (PB12); also elsewhere on the board
/HF Module/MISO: U1.57 (PB5); also elsewhere on the board
/HF Module/MOSI: U1.56 (PB4); also elsewhere on the board
/HF Module/NRF_RX_MISO: U1.52 (PC11); also elsewhere on the board
/HF Module/NRF_TX_SCK: U1.51 (PC10); also elsewhere on the board
/HF Module/NSS: U1.55 (PB3); also elsewhere on the board
/MCU/ADC_TEMP: U1.17 (PA3); also elsewhere on the board
/MCU/AN_IN: U1.11 (PC3); also elsewhere on the board
/MCU/CURRENT_1: U1.8 (PC0); also elsewhere on the board
/MCU/CURRENT_2: U1.9 (PC1); also elsewhere on the board
/MCU/CURRENT_3: U1.10 (PC2); also elsewhere on the board
/MCU/H1: U1.41 (PA8); also elsewhere on the board
/MCU/H2: U1.42 (PA9); also elsewhere on the board
/MCU/H3: U1.43 (PA10); also elsewhere on the board
/MCU/HALL_1: U1.37 (PC6); also elsewhere on the board
/MCU/HALL_2: U1.38 (PC7); also elsewhere on the board
/MCU/HALL_3: U1.39 (PC8); also elsewhere on the board
/MCU/HALL_ROT_A: U1.3 (PC14); also elsewhere on the board
/MCU/HALL_ROT_B: U1.4 (PC15); also elsewhere on the board
/MCU/HALL_TRIG: U1.2 (PC13); also elsewhere on the board
/MCU/I2C1_SCL: U1.61 (PB8); also elsewhere on the board
/MCU/I2C1_SDA: U1.62 (PB9); also elsewhere on the board
/MCU/L1: U1.34 (PB13); also elsewhere on the board
/MCU/L2: U1.35 (PB14); also elsewhere on the board
/MCU/L3: U1.36 (PB15); also elsewhere on the board
/MCU/LED_GREEN: U1.26 (PB0); also elsewhere on the board
/MCU/LED_RED: U1.27 (PB1); also elsewhere on the board
/MCU/MISO_ADC_EXT2: U1.22 (PA6); also elsewhere on the board
/MCU/NRST: C5.1, U1.7 (NRST); also elsewhere on the board
/MCU/PB2: U1.28 (PB2); also elsewhere on the board
/MCU/PB6: U1.58 (PB6); also elsewhere on the board
/MCU/PC5: U1.25 (PC5); also elsewhere on the board
/MCU/RX_SDA_NSS: U1.20 (PA4), U1.30 (PB11); also elsewhere on the board
/MCU/SCK_ADC_EXT: U1.21 (PA5); also elsewhere on the board
/MCU/SERVO: U1.59 (PB7); also elsewhere on the board
/MCU/SWCLK: U1.49 (PA14); also elsewhere on the board
/MCU/SWDIO: U1.46 (PA13); also elsewhere on the board
/MCU/TEMP_MOTOR: U1.24 (PC4); also elsewhere on the board
/MCU/TX_SCL_MOSI: U1.23 (PA7), U1.29 (PB10); also elsewhere on the board
/MCU/USB_D+: U1.45 (PA12); also elsewhere on the board
/MCU/USB_D-: U1.44 (PA11); also elsewhere on the board
/POWER/CURR_FILTER: U1.54 (PD2); also elsewhere on the board
GND: C3.2, C4.2, C5.2, C6.1, C7.1, C8.1, C9.1, C10.1, C11.1, C12.1, C13.1, U1.12 (VSSA), U1.18 (VSS), U1.60 (BOOT0), U1.63 (VSS); also elsewhere on the board
unnamed: C3.1, U1.5 (PH0), Y1.1
unnamed: C4.1, U1.6 (PH1), Y1.2
unnamed: C6.2, U1.31 (VCAP_1)
unnamed: C7.2, U1.47 (VCAP_2)
VCC: C8.2, C9.2, C10.2, C11.2, C12.2, C13.2, U1.1 (VBAT), U1.13 (VDDA), U1.19 (VDD), U1.32 (VDD), U1.48 (VDD), U1.64 (VDD); also elsewhere on the board

Notes on the sheet:
Controller

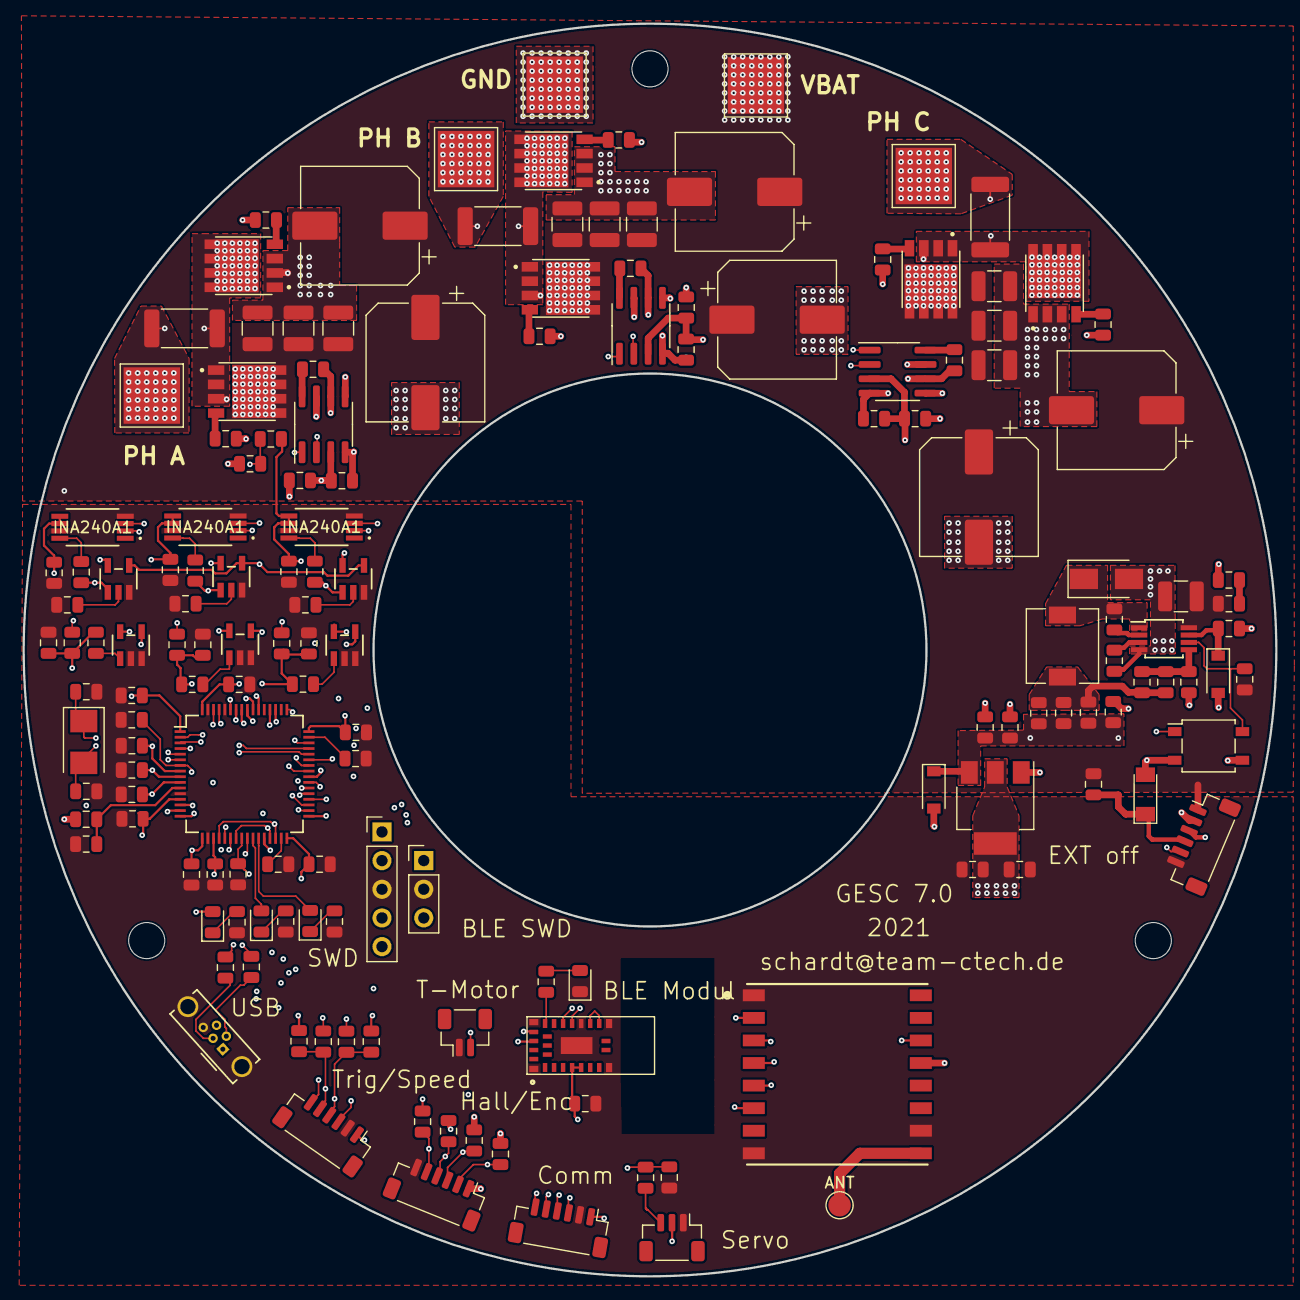
[picture p14: board gesc.kicad_pcb from above]

Board: 4 copper layers, 111.0 x 111.0 mm, 159 parts (0 on the bottom side), 107 nets.

Other parts of the board:
ANT: Antenna; TestPoint_Pad_D2.0mm

Their connections:
unnamed 102: ANT.1; also elsewhere on the board
