CTSchorsch/gesc/(commit log)

2018-11-28 Moved Project to KiCad
    [gsvesc.kicad_pcb, gsvesc.sch, gsvesc_drv.sch, gsvesc_nrf.sch, gsvesc_pwr.sch, gsvesc_pwrctrl.sch, gsvesc_uc.sch]
2018-11-28 aufräumen
    [gsvesc_drv.sch, gsvesc_nrf.sch, gsvesc_pwr.sch, gsvesc_pwrctrl.sch]
2018-11-28 Aufgeräumt Teil 2
    [gsvesc_drv.sch, gsvesc_pwr.sch, gsvesc_pwrctrl.sch]
2018-11-28 datei wiederhergestellt
    [gsvesc_nrf.sch]
2018-12-11 SCM Fertig
    [gsvesc.kicad_pcb, gsvesc.sch, gsvesc_drv.sch, gsvesc_nrf.sch, gsvesc_pwr.sch, gsvesc_pwrctrl.sch, gsvesc_uc.sch]
2019-01-04 design finished gerber created
    [gsvesc-B.Cu.gbr, gsvesc-B.Mask.gbr, gsvesc-B.Paste.gbr, gsvesc-B.SilkS.gbr, gsvesc-Edge.Cuts.gbr, gsvesc-F.Cu.gbr, gsvesc-F.Mask.gbr, gsvesc-F.Paste.gbr]
2019-01-22 Revision 2.0a
    [gsvesc-B.Cu.gbr, gsvesc-B.Mask.gbr, gsvesc-B.Paste.gbr, gsvesc-B.SilkS.gbr, gsvesc-Edge.Cuts.gbr, gsvesc-F.Cu.gbr, gsvesc-F.Mask.gbr, gsvesc-F.Paste.gbr]
2019-02-19 fix some bugs
    [gsvesc.kicad_pcb, gsvesc.sch, gsvesc_pwrctrl.sch, gsvesc_uc.sch]
2019-02-19 change inverter to npn :)
    [gsvesc_drv.sch, gsvesc_pwr.sch, gsvesc_pwrctrl.sch]
2019-02-21 BUG: Inrush current force lt1910 to switch off
2019-12-10 GSVESC 2.0
    [gsvesc.csv, gsvesc.kicad_pcb]
2020-01-29 gsesc v3, work in progress
    [gsvesc.kicad_pcb, gsvesc.sch, gsvesc_drv.sch, gsvesc_nrf.sch, gsvesc_pwr.sch, gsvesc_uc.sch]
2020-01-29 library wieder im projektordner
    [gsvesc.kicad_pcb, gsvesc.sch]
2020-02-06 Umbau auf doppelFET, INA240
    [gsvesc.sch, gsvesc_pwr.sch]
2020-02-10 First Version V3 - Change FET to TPH2R506PL - 1oz copper on all layer - switch analog amp to INA240 - remove Elkos - add more ceramic c - separate current measurement tracks from gate driver tracks -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
    [gsvesc.kicad_pcb, gsvesc_pwr.sch]
2020-02-10 Version 3 update - JST as SMD part - move FET tracks
    [gsvesc-B.Cu.gbr, gsvesc-B.Mask.gbr, gsvesc-B.Paste.gbr, gsvesc-B.SilkS.gbr, gsvesc-Edge.Cuts.gbr, gsvesc-F.Cu.gbr, gsvesc-F.Mask.gbr, gsvesc-F.Paste.gbr]
2020-02-11 implement remarks/changes from Alex
    [gsvesc-B.Cu.gbr, gsvesc-B.Mask.gbr, gsvesc-B.Paste.gbr, gsvesc-B.SilkS.gbr, gsvesc-Edge.Cuts.gbr, gsvesc-F.Cu.gbr, gsvesc-F.Mask.gbr, gsvesc-F.Paste.gbr]
2020-02-11 Fertigungsdaten V3.0
    [gsvesc-B.Cu.gbr, gsvesc-B.Mask.gbr, gsvesc-B.Paste.gbr, gsvesc-B.SilkS.gbr, gsvesc-Edge.Cuts.gbr, gsvesc-F.Cu.gbr, gsvesc-F.Mask.gbr, gsvesc-F.Paste.gbr]
2020-04-09 V3 finish, JLC ready
    [gsvesc-B.Cu.gbr, gsvesc-B.Mask.gbr, gsvesc-B.Paste.gbr, gsvesc-B.SilkS.gbr, gsvesc-Edge.Cuts.gbr, gsvesc-F.Cu.gbr, gsvesc-F.Mask.gbr, gsvesc-F.Paste.gbr]
2020-04-10 V4 first version
    [driver.sch, gsvesc.sch, gsvesc_drv.sch, gsvesc_nrf.sch, gsvesc_pwr.sch, gsvesc_uc.sch]
2020-04-10 5V raus
    [driver.sch]
2020-04-11 Power Supply geändert
    [driver.sch, gsvesc.sch, gsvesc_pwr.sch, gsvesc_uc.sch]
2020-04-11 Powersupply geändert
    [driver.sch, gsvesc.csv, gsvesc.sch, gsvesc.xml, gsvesc_pwr.sch]
2020-04-20 V4 pre
    [driver.sch, gsvesc.csv, gsvesc.kicad_pcb, gsvesc.sch, gsvesc.xml, gsvesc_pwr.sch, jlcbom.xlsx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]
2020-04-20 V4 alpha
    [driver.sch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]
2020-04-21 Add boot-diode to use LM5109A as alternative FET driver
    [driver.sch, gsvesc.kicad_pcb]
2020-04-21 einige Bauteile geändert, so dass sie Basic Parts bei JLC sind
    [driver.sch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]
2020-04-21 BLE Modul hinzugefügt, optional
    [gsvesc-B.Cu.gbr, gsvesc-B.Mask.gbr, gsvesc-B.Paste.gbr, gsvesc-B.SilkS.gbr, gsvesc-Edge.Cuts.gbr, gsvesc-F.Cu.gbr, gsvesc-F.Mask.gbr, gsvesc-F.Paste.gbr]
2020-04-28 V4 before review
    [gsvesc-B.Cu.gbr, gsvesc-B.Mask.gbr, gsvesc-B.Paste.gbr, gsvesc-B.SilkS.gbr, gsvesc-Edge.Cuts.gbr, gsvesc-F.Cu.gbr, gsvesc-F.Mask.gbr, gsvesc-F.Paste.gbr]
2020-05-01 small changes
    [gsvesc-B.Cu.gbr, gsvesc-B.Mask.gbr, gsvesc-B.Paste.gbr, gsvesc-B.SilkS.gbr, gsvesc-Edge.Cuts.gbr, gsvesc-F.Cu.gbr, gsvesc-F.Mask.gbr, gsvesc-F.Paste.gbr]
2020-05-02 Planes und Vias
    [gsvesc.kicad_pcb, gsvesc.sch, gsvesc_uc.sch]
2020-05-04 fertig gerouted
    [gsvesc-B.Cu.gbr, gsvesc-B.Mask.gbr, gsvesc-B.Paste.gbr, gsvesc-B.SilkS.gbr, gsvesc-Edge.Cuts.gbr, gsvesc-F.Cu.gbr, gsvesc-F.Mask.gbr, gsvesc-F.Paste.gbr]
2020-05-04 Ready for JLC
    [gsvesc-B.Cu.gbr, gsvesc-B.Mask.gbr, gsvesc-B.Paste.gbr, gsvesc-B.SilkS.gbr, gsvesc-Edge.Cuts.gbr, gsvesc-F.Cu.gbr, gsvesc-F.Mask.gbr, gsvesc-F.Paste.gbr]
2020-05-26 some bug fixes for next pcb-run
    - Add JST connector for Motor Temp
    - Remove USB 5V
    - add correct footprint for D8,9,10
    - add JST connector for external off
    [driver.sch, gsvesc.kicad_pcb, gsvesc.sch]
2020-05-26 clean up
    [gsvesc-B.Cu.gbr, gsvesc-B.Mask.gbr, gsvesc-B.Paste.gbr, gsvesc-B.SilkS.gbr, gsvesc-Edge.Cuts.gbr, gsvesc-F.Cu.gbr, gsvesc-F.Mask.gbr, gsvesc-F.Paste.gbr]
2020-05-27 BUG Fixes, see BUGS.txt
    [gsvesc.kicad_pcb, gsvesc.sch, gsvesc_uc.sch]
2020-06-02 bug fixing
    [driver.sch, gsvesc.kicad_pcb, gsvesc.sch]
2020-08-01 add PDF
    [driver.sch, gsvesc.kicad_pcb, gsvesc.sch]
2020-08-03 hw 4 freeze
    [gsvesc.kicad_pcb, gsvesc.sch]
2020-08-08 pre review
    [gsvesc-B.Cu.gbr, gsvesc-B.Mask.gbr, gsvesc-B.Paste.gbr, gsvesc-B.SilkS.gbr, gsvesc-Edge.Cuts.gbr, gsvesc-F.Cu.gbr, gsvesc-F.Mask.gbr, gsvesc-F.Paste.gbr]
2020-08-10 Apply Feedback from Martin:
    - Add more GND Vias to lowside FET
    - use "power GND" for driver
    [gsvesc.kicad_pcb]
2020-08-10 some more vias
    [gsvesc-B.Cu.gbr, gsvesc-B.Mask.gbr, gsvesc-B.Paste.gbr, gsvesc-B.SilkS.gbr, gsvesc-Edge.Cuts.gbr, gsvesc-F.Cu.gbr, gsvesc-F.Mask.gbr, gsvesc-F.Paste.gbr]
2020-08-11 change Caps
    [gsvesc-B.Cu.gbr, gsvesc-B.Mask.gbr, gsvesc-B.Paste.gbr, gsvesc-B.SilkS.gbr, gsvesc-Edge.Cuts.gbr, gsvesc-F.Cu.gbr, gsvesc-F.Mask.gbr, gsvesc-F.Paste.gbr]
2020-09-02 HW5 ready
    [gsvesc-B.Cu.gbr, gsvesc-B.Mask.gbr, gsvesc-B.Paste.gbr, gsvesc-B.SilkS.gbr, gsvesc-Edge.Cuts.gbr, gsvesc-F.Cu.gbr, gsvesc-F.Mask.gbr, gsvesc-F.Paste.gbr]
2020-10-19 current range too small, fix with new Shunt Resistor
    !! better: use ina240A1
    [gsvesc_pwr.sch]
2021-01-08 Add Pull ups for i2c change shunt
    [driver.sch, gsvesc.kicad_pcb, gsvesc.sch, gsvesc_nrf.sch, gsvesc_pwr.sch, gsvesc_uc.sch]
2021-01-25 PCB updated: - reroute SH_X - change 3V3 Power supply - add VBUS to 3V3 regulator - use LM5107 - change Layer/Plane assignment - move current sense tracks to layer 2
    [driver.sch, gesc.kicad_pcb, gesc_pwr.sch]
2021-01-25 - remove solder-mask from bottom layer
    [driver.sch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]
2021-01-27 - add separate connection between lowside source and driver
    [gesc.kicad_pcb]
2021-02-02 JLC ready
    [gesc-B_Cu.gbr, gesc-B_Mask.gbr, gesc-B_Paste.gbr, gesc-B_SilkS.gbr, gesc-Edge_Cuts.gbr, gesc-F_Cu.gbr, gesc-F_Mask.gbr, gesc-F_Paste.gbr]
2021-02-04 new schematic export
2021-02-18 BUGS ergänzt
    [driver.sch, gesc.kicad_pcb, gesc.sch, gesc_nrf.sch, gesc_pwr.sch, gesc_uc.sch]
2021-02-19 |--- Add Schottky between phase and gnd at HS pin of LM5107 |--- Add 5R6 in phase line to HS pin of LM5107 |--- Change high side bypass cap to 10u/25V |--- Add 14V TVS diode parallel to high side byp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
    [driver.sch, gesc.kicad_pcb, gesc_pwr.sch]
2021-02-26 Version mit UCC27211
    [driver.sch, gesc.kicad_pcb]
2021-03-04 - new driver 2ED2304S06F - separat Elkos for each phase - new FET placement
    [driver.sch, gesc.kicad_pcb, gesc.sch, gesc_pwr.sch]
2021-03-06 Version rund platziert
    [driver.sch, gesc.kicad_pcb]
2021-08-29 V7 PCB order
    [driver.sch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]
2021-12-03 small fixes
    [gesc.kicad_pcb, gesc7_bom_digikey.xlsx]
